laurenzooz/optical-pulse-oximeter/README.md

### TODO:

* Two ways to measure the pulse:
	* Perform FFT, find the highest amplitude frequency, calculate pulse from that	
	* Measure the time between the peaks, few peaks at a time, calculate the average of the durations between peaks
