laurenzooz/optical-pulse-oximeter/HW/pulseoximeter.pdf

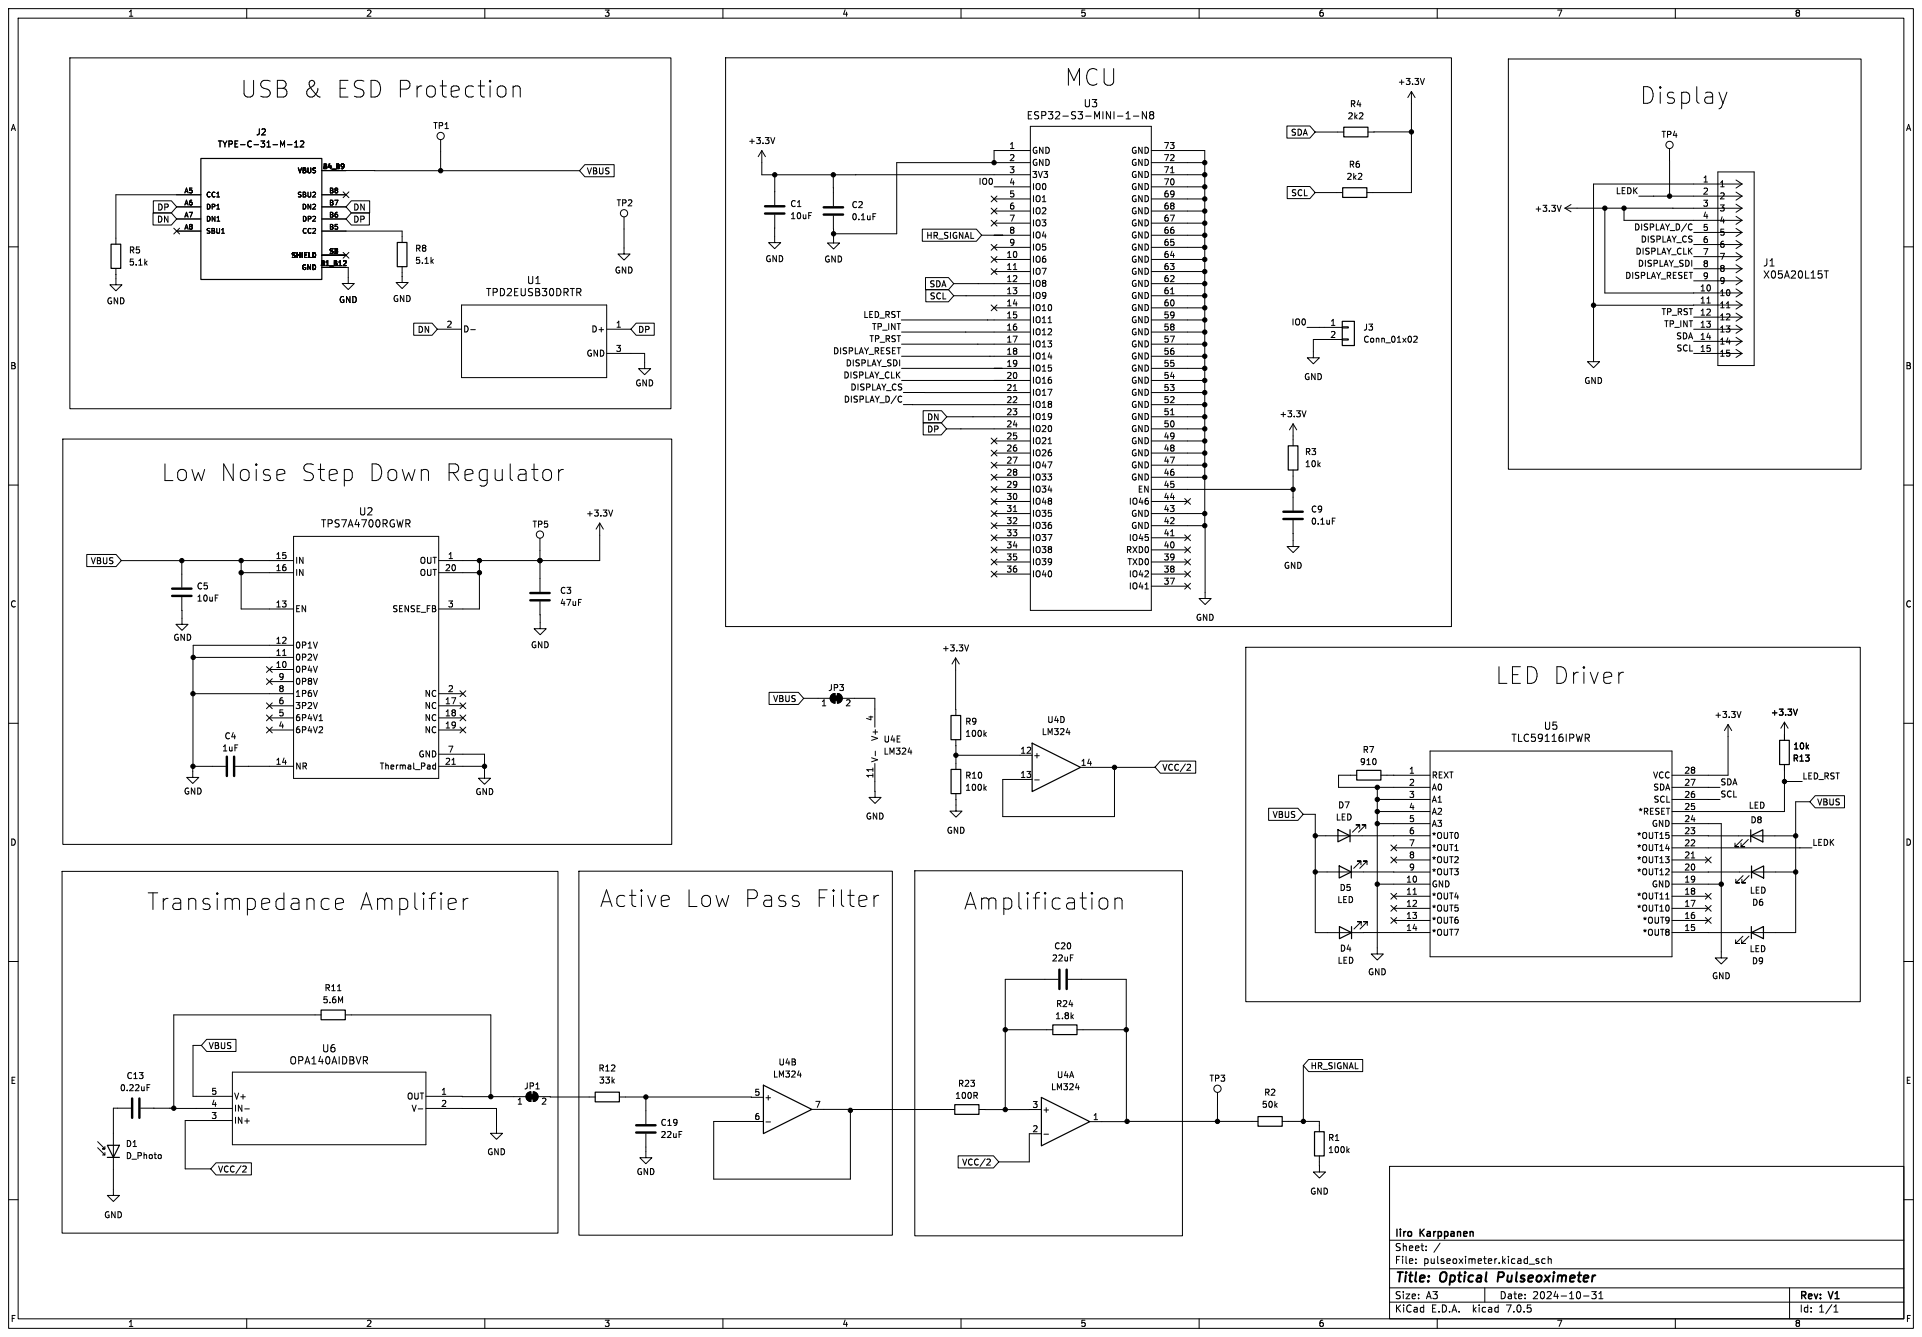
[picture p1: page 1]

IO0 Active Low Pass Filter

TP_RST Low Noise Step Down Regulator
