laurenzooz/optical-pulse-oximeter/HW/pulseoximeter.kicad_pcb

## KiCad design HW/pulseoximeter.kicad_pcb (2024-12-01)

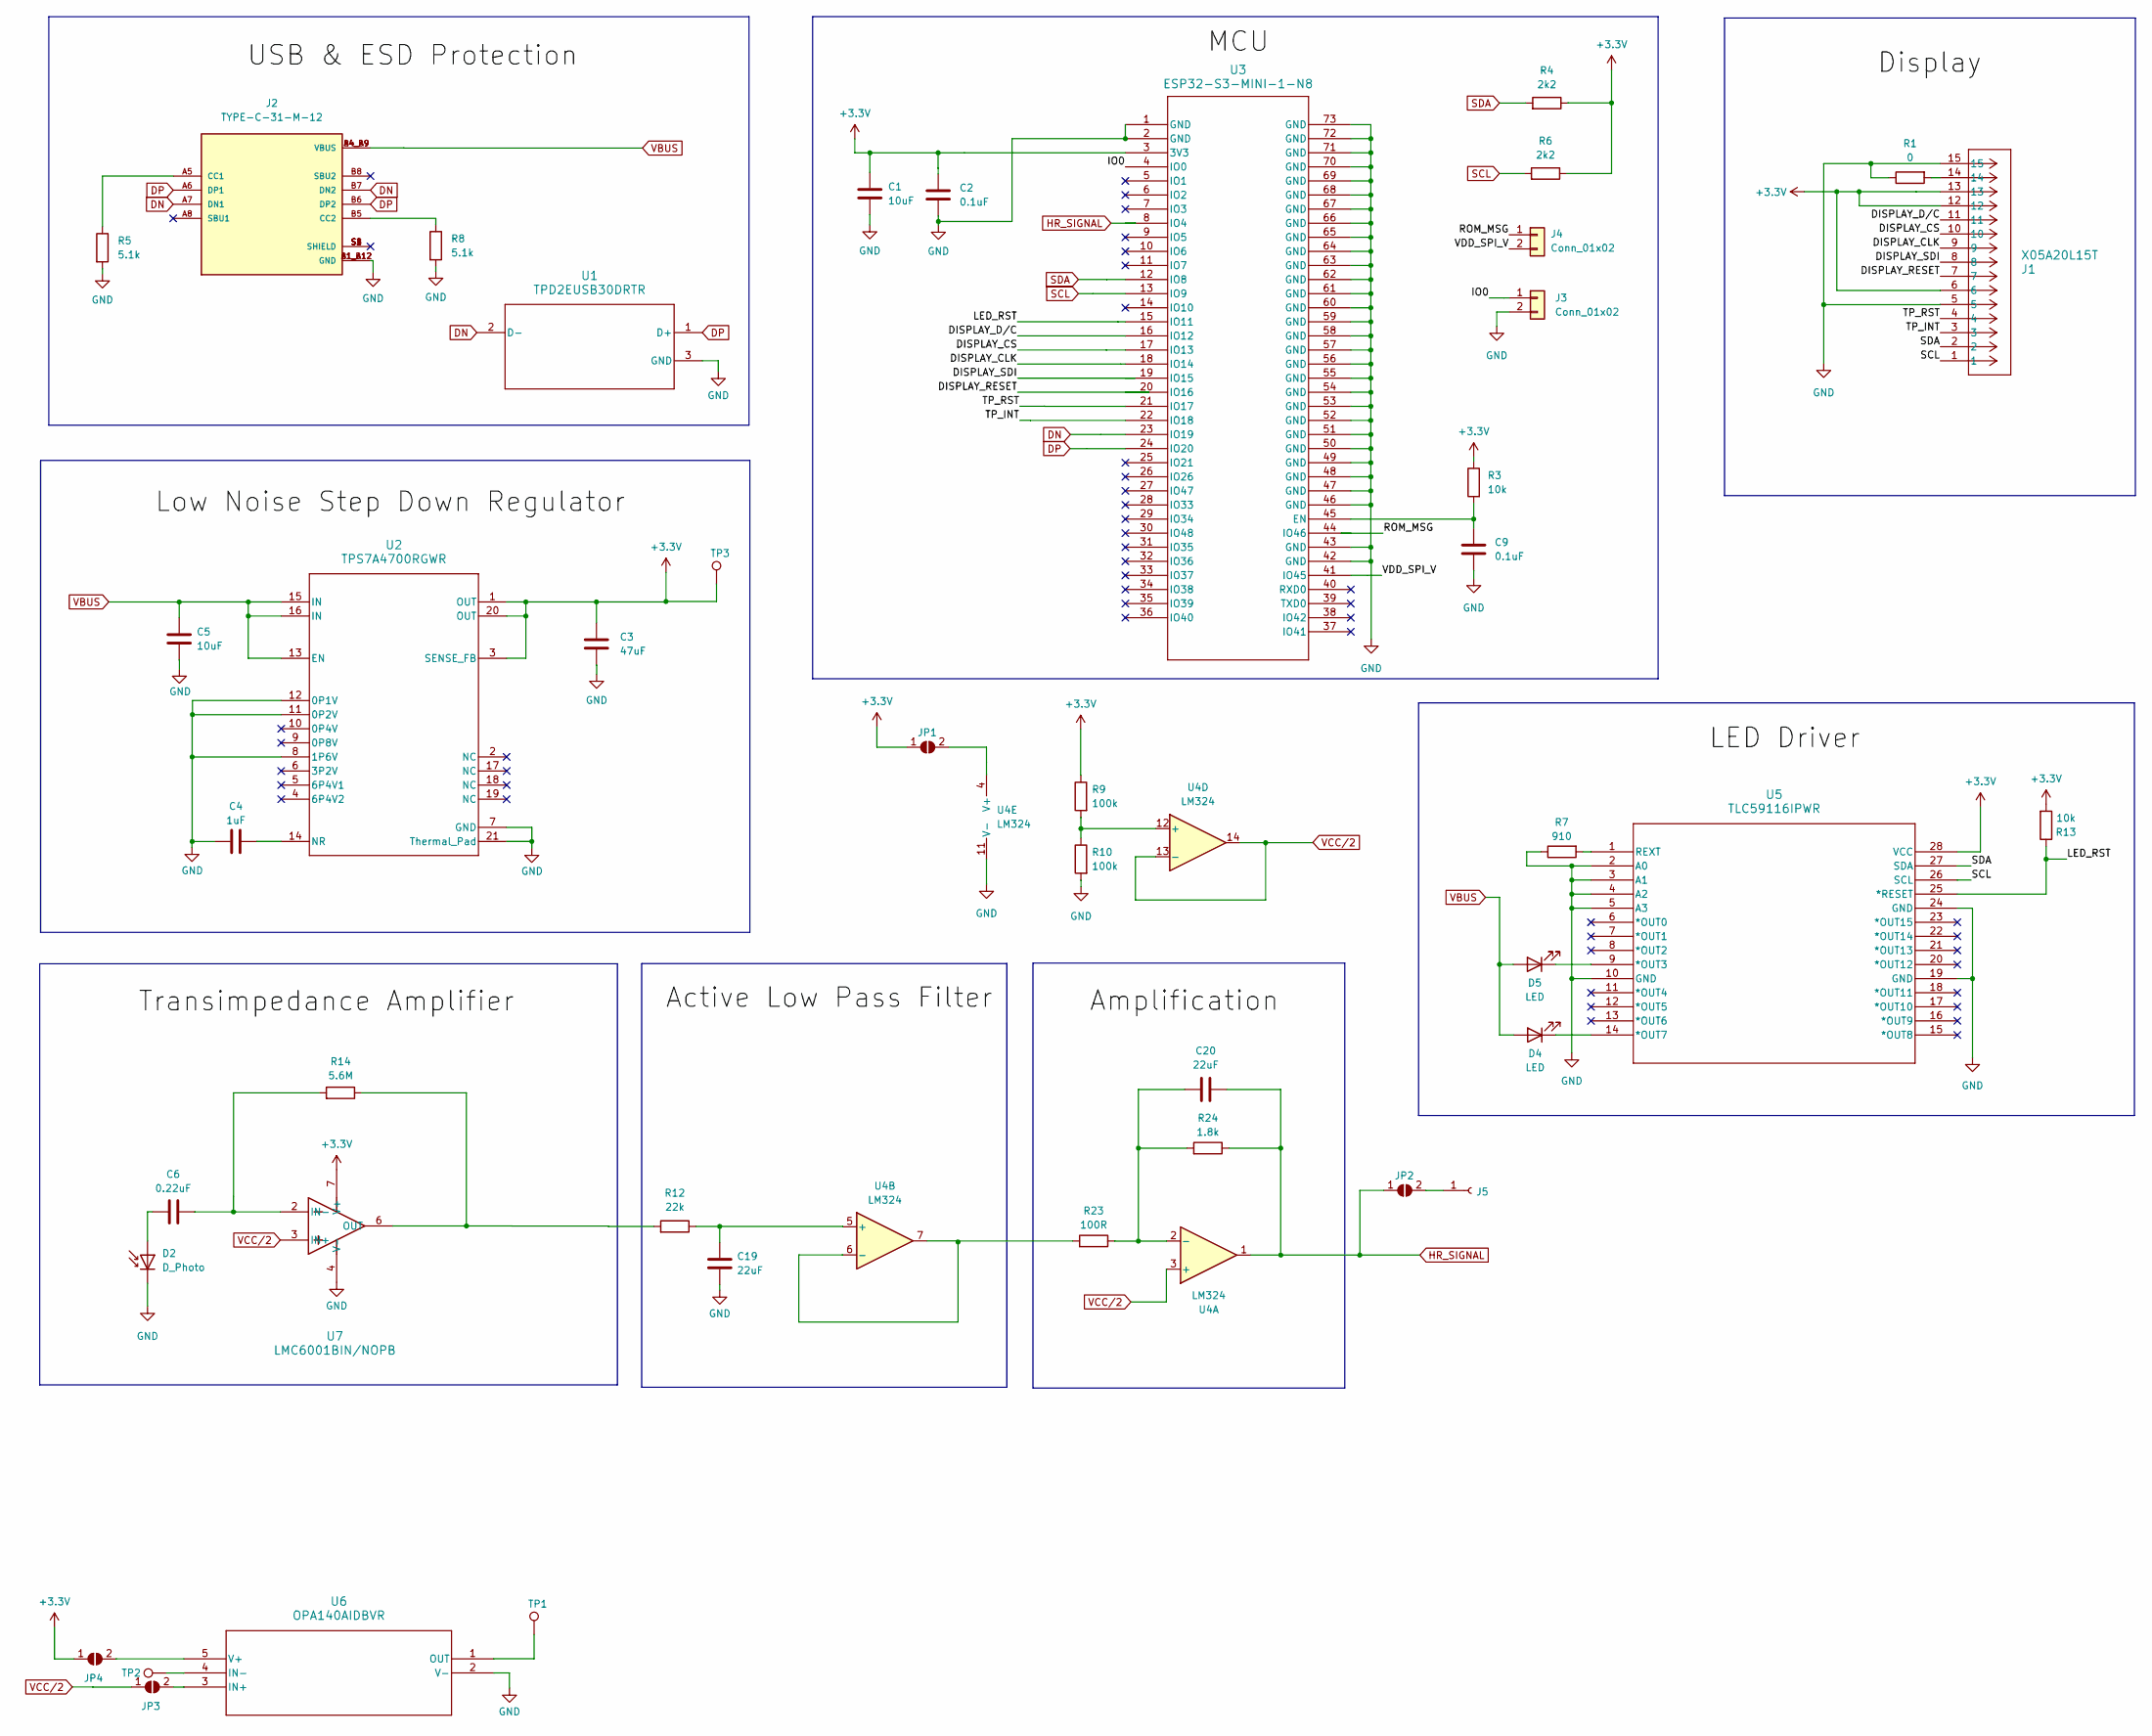
[picture p2: schematic pulseoximeter.kicad_sch, Optical Pulseoximeter]

Parts:
C1: 10uF; C_0603_1608Metric
C2, C9: 0.1uF; C_0603_1608Metric
C3: 47uF; C_0603_1608Metric
C4: 1uF; C_0402_1005Metric
C5: 10uF; C_0402_1005Metric
C6: 0.22uF; C_0603_1608Metric
C19, C20: 22uF; C_0603_1608Metric
D2: D_Photo; LED_D3.0mm
D4, D5: LED; LED_D3.0mm
J1: X05A20L15T; CONN_X05A20L15T_XKB
J2: TYPE-C-31-M-12; PARTREV 2020.12.08
J3, J4: Conn_01x02; PinHeader_1x02_P2.54mm_Vertical
J5: Conn_01x01_Socket; PinHeader_1x01_P2.54mm_Vertical
JP1, JP2, JP3, JP4: SolderJumper_2_Open; SolderJumper-2_P1.3mm_Open_RoundedPad1.0x1.5mm
R1: 0; R_0603_1608Metric
R3, R13: 10k; R_0603_1608Metric
R4, R6: 2k2; R_0603_1608Metric
R5, R8: 5.1k; R_0402_1005Metric
R7: 910; R_0603_1608Metric
R9, R10: 100k; R_0603_1608Metric
R12: 22k; R_0805_2012Metric
R14: 5.6M; R_0805_2012Metric
R23: 100R; R_0603_1608Metric
R24: 1.8k; R_0603_1608Metric
TP1, TP2, TP3: TestPoint; TestPoint_Pad_D2.0mm
U1: TPD2EUSB30DRTR; DRT0003A
U2: TPS7A4700RGWR; RGW0020A-IPC_A
U3: ESP32-S3-MINI-1-N8; ESP32-S3-MINI-1_EXP
U4: LM324; D14
U5: TLC59116IPWR; PW28
U6: OPA140AIDBVR; DBV5
U7: LMC6001BIN/NOPB; DIP794W45P254L959H508Q8

Connections:
+3.3V: C1.1, C2.1, C3.1, J1.6, J1.12, J1.13, JP1.1 (A), JP4.1 (A), R3.1, R4.1, R6.1, R9.1, R13.2, TP3.1, U2.1 (OUT), U2.3 (SENSE_FB), U2.20 (OUT), U3.3 (3V3), U5.28 (VCC), U7.7 (V+)
/DISPLAY_CLK: J1.9, U3.18 (IO14)
/DISPLAY_CS: J1.10, U3.17 (IO13)
/DISPLAY_D/C: J1.11, U3.16 (IO12)
/DISPLAY_RESET: J1.7, U3.20 (IO16)
/DISPLAY_SDI: J1.8, U3.19 (IO15)
/IO0: J3.1, U3.4 (IO0)
/LED_RST: R13.1, U3.15 (IO11), U5.25 (*RESET)
/ROM_MSG: J4.1, U3.44 (IO46)
/TP_INT: J1.3, U3.22 (IO18)
/TP_RST: J1.4, U3.21 (IO17)
/VDD_SPI_V: J4.2, U3.41 (IO45)
DN: J2.A7 (DN1), J2.B7 (DN2), U1.2 (D-), U3.23 (IO19)
DP: J2.A6 (DP1), J2.B6 (DP2), U1.1 (D+), U3.24 (IO20)
GND: C1.2, C2.2, C3.2, C4.1, C5.2, C9.2, C19.2, D2.1 (K), J1.5, J1.15, J2.A1_B12 (GND), J2.B1_A12 (GND), J3.2, R1.1, R5.2, R7.1, R8.2, R10.2, U1.3 (GND), U2.7 (GND), U2.8 (1P6V), U2.11 (0P2V), U2.12 (0P1V), U2.21 (Thermal_Pad), U3.1 (GND), U3.2 (GND), U3.42 (GND), U3.43 (GND), U3.46 (GND), U3.47 (GND), U3.48 (GND), U3.49 (GND), U3.50 (GND), U3.51 (GND), U3.52 (GND), U3.53 (GND), U3.54 (GND), U3.55 (GND), U3.56 (GND), U3.57 (GND), U3.58 (GND), U3.59 (GND), U3.60 (GND), U3.61 (GND), U3.62 (GND), U3.63 (GND), U3.64 (GND), U3.65 (GND), U3.66 (GND), U3.67 (GND), U3.68 (GND), U3.69 (GND), U3.70 (GND), U3.71 (GND), U3.72 (GND), U3.73 (GND), U4.11 (V-), U5.2 (A0), U5.3 (A1), U5.4 (A2), U5.5 (A3), U5.10 (GND), U5.19 (GND), U5.24 (GND), U6.2 (V-), U7.4 (V-)
HR_SIGNAL: C20.1, JP2.1 (A), R24.1, U3.8 (IO4), U4.1
unnamed: C6.1, D2.2 (A)
unnamed: D4.1 (K), U5.14 (*OUT7)
unnamed: D5.1 (K), U5.9 (*OUT3)
unnamed: J1.14, R1.2
unnamed: J2.A5 (CC1), R5.1
unnamed: J2.B5 (CC2), R8.1
unnamed: J5.1, JP2.2 (B)
unnamed: JP1.2 (B), U4.4 (V+)
unnamed: JP3.2 (B), U6.3 (IN+)
unnamed: JP4.2 (B), U6.5 (V+)
unnamed: C4.2, U2.14 (NR)
unnamed: C9.1, R3.2, U3.45 (EN)
unnamed: C20.2, R23.1, R24.2, U4.2 (-)
unnamed: C19.1, R12.1, U4.5 (+)
unnamed: R23.2, U4.6 (-), U4.7
unnamed: R9.2, R10.1, U4.12 (+)
unnamed: R7.2, U5.1 (REXT)
unnamed: TP2.1, U6.4 (IN-)
unnamed: TP1.1, U6.1 (OUT)
unnamed: C6.2, R14.2, U7.2 (IN-)
unnamed: R12.2, R14.1, U7.6 (OUT)
SCL: J1.1, R6.2, U3.13 (IO9), U5.26 (SCL)
SDA: J1.2, R4.2, U3.12 (IO8), U5.27 (SDA)
VBUS: C5.1, D4.2 (A), D5.2 (A), J2.A4_B9 (VBUS), J2.B4_A9 (VBUS), U2.13 (EN), U2.15 (IN), U2.16 (IN)
VCC/2: JP3.1 (A), U4.3 (+), U4.13 (-), U4.14, U7.3 (IN+)

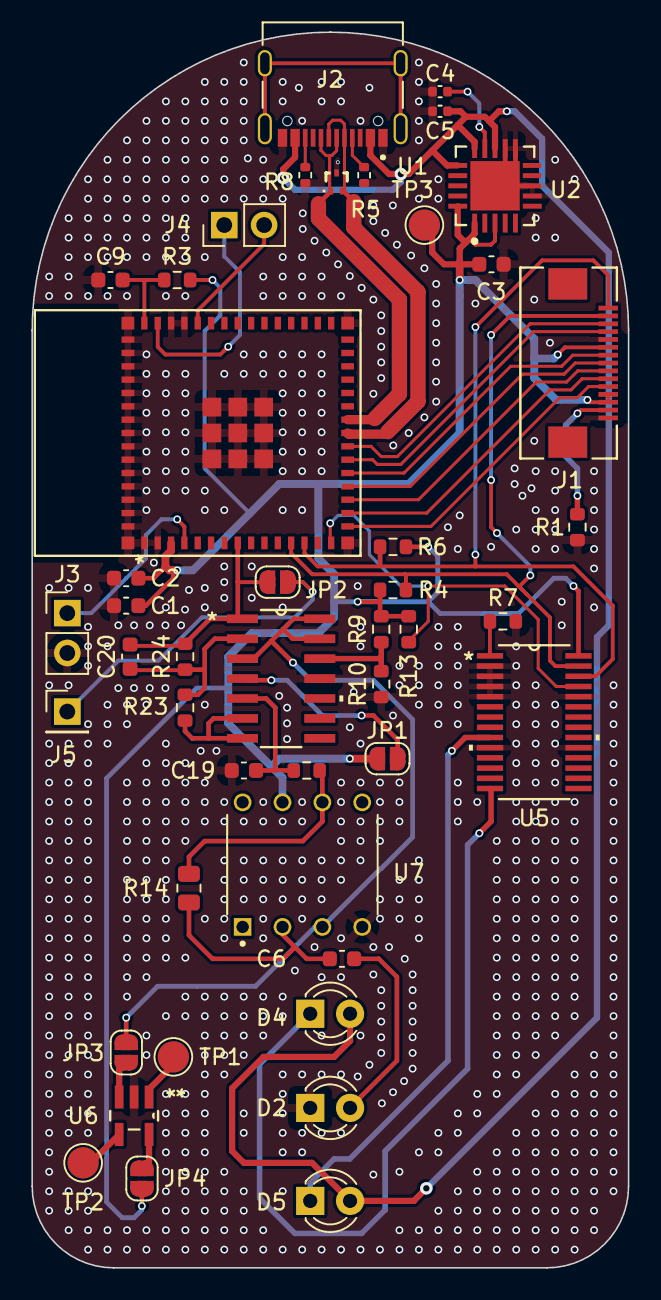
[picture p3: board pulseoximeter.kicad_pcb from above]

Board: 2 copper layers, 38.0 x 78.7 mm, 45 parts (0 on the bottom side), 41 nets.
