laurenzooz/optical-pulse-oximeter/Firmware/src/roboto_38.h

// Created by https://oleddisplay.squix.ch/ Consider a donation
// In case of problems make sure that you are using the font file with the correct version!
const uint8_t Roboto_Medium_38Bitmaps[] PROGMEM = {

	// Bitmap Data:
	0x00, // ' '
	0xF3,0xCF,0x3C,0xF3,0xCF,0x3C,0xF3,0xCF,0x3C,0xF3,0xCF,0x3C,0xF3,0xCF,0x00,0x00,0x07,0x3E,0xFB,0xEF,0x00, // '!'
	0xE7,0xB9,0xEE,0x7B,0x9E,0xE7,0xB9,0xCE,0x73,0x9C,0xE7,0x39,0xC0, // '"'
	0x00,0xE1,0xC0,0x0E,0x0E,0x00,0x70,0xF0,0x03,0x87,0x00,0x1C,0x38,0x00,0xE1,0xC0,0x0E,0x0E,0x0F,0xFF,0xFE,0x7F,0xFF,0xF3,0xFF,0xFF,0x80,0xE1,0xC0,0x0F,0x0E,0x00,0x70,0x70,0x03,0x87,0x00,0x1C,0x38,0x00,0xE1,0xC0,0xFF,0xFF,0xE7,0xFF,0xFF,0x3F,0xFF,0xF8,0x1C,0x38,0x00,0xE1,0xC0,0x07,0x0E,0x00,0x78,0x70,0x03,0x83,0x80,0x1C,0x38,0x00,0xE1,0xC0,0x07,0x0E,0x00, // '#'
	0x00,0xE0,0x00,0x1C,0x00,0x03,0x80,0x00,0x70,0x00,0x3F,0x80,0x1F,0xFC,0x07,0xFF,0xC1,0xFF,0xFC,0x3E,0x1F,0x8F,0x81,0xF1,0xF0,0x1F,0x3E,0x03,0xE7,0xC0,0x00,0xF8,0x00,0x0F,0xC0,0x01,0xFE,0x00,0x1F,0xF0,0x01,0xFF,0x80,0x0F,0xFC,0x00,0x3F,0xC0,0x01,0xF8,0x00,0x0F,0x80,0x01,0xF7,0xC0,0x3E,0xF8,0x07,0xDF,0x00,0xF9,0xF8,0x3E,0x3F,0xFF,0xC3,0xFF,0xF0,0x3F,0xFC,0x01,0xFE,0x00,0x07,0x00,0x00,0xE0,0x00,0x1C,0x00,0x03,0x80,0x00, // '$'
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
	  {  1898,  18,  27,  22,    3,  -27 }, // 'E'
	  {  1959,  18,  27,  22,    3,  -27 }, // 'F'
	  {  2020,  23,  27,  27,    2,  -27 }, // 'G'
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
};
const GFXfont Roboto_Medium_38 PROGMEM = {
(uint8_t  *)Roboto_Medium_38Bitmaps,(GFXglyph *)Roboto_Medium_38Glyphs,0x20, 0x7E, 46};
