laurenzooz/optical-pulse-oximeter/(commit log)

2024-10-28 Added sample FFT made with chatgpt
2024-10-28 Update code to calculate and print the pulse
2024-10-30 current code
2024-11-03 added schematic v1
    [bom.csv, designators.csv, positions.csv, pulseoximeter.kicad_pcb, pulseoximeter.kicad_sch]
2024-12-01 implemented dynamic chart y-axis scaling
    [bom.csv, designators.csv, positions.csv, pulseoximeter.kicad_pcb, pulseoximeter.kicad_sch]
